bogdan-tirzioru/guitarAmp/README.md

# guitarAmp

STM32-based guitar effects and amplifier project. The first design focuses on a
working guitar audio path, headphone listening, a backing-track input, and USB
recording. Initial effects are overdrive and delay.

Status: hardware planning and CubeMX peripheral/pin allocation. Requirements below
describe the intended design, not completed or validated functionality.

## Power architecture and schematic status

The guitarAmp board is planned as a **self-powered** design using the external
±12 V supply shared with the reused LM1875 amplifier board. USB-C is for data and
VBUS detection; USB VBUS must not power the board.

The schematic still needs a complete power-entry and regulator design. The target
rails are ±12 V for the analog preamp, +3V3 for the STM32 and codec analog/I/O
domains, +1.8 V for the codec core, and +5 V for the Waveshare display module. The
generic display connector should carry the required +5 V module supply, +3V3 logic
rail, and ground; verify the exact Rev 4.0 module/adapter pinout and current draw
before freezing it. Regulator selection, current budgets, return paths, protection
and startup sequencing remain open.

The latest schematic review is tracked in
[`docs/schematic-todo.md`](docs/schematic-todo.md). Current blockers include the
codec DRVDD_1 supply, a floating common return for the eight control-filter
capacitors, three reversed polarized codec-input capacitors, input overload
protection/headroom, and the incomplete power tree. The control ADC paths, 1 MΩ
guitar input, display/UART connectors and SD-detect pull-up are reflected in the
current source. Native Altium ERC and hardware validation are still pending.

## Agreed requirements

| Area | Requirement |
| --- | --- |
| Guitar input | Mono instrument input with approximately 1 MΩ input impedance, protection, and suitable analog gain/headroom. |
| Backing-track input | Auxiliary line input. Accept stereo L/R at the connector and sum to mono before the codec using a proper summing circuit; never short source outputs together. |
| Conversion | One codec IC with two ADC channels and two DAC channels. Separate ADC/DAC ICs are outside the first-design scope. |
| Channel allocation | ADC left: guitar. ADC right: mono auxiliary. Keep sources separate until digital processing/mixing. |
| Bluetooth option | BM83SM1-00AB A2DP receiver; I²S into STM32, independent backing-track level, bypass guitar effects, included in the USB recording mix. |
| Effects | Process guitar through STM32 overdrive/delay; auxiliary audio bypasses guitar effects. |
| Mixing | Independent guitar and auxiliary levels, followed by output level control. Mix in STM32 so the backing track is included in USB recording. |
| Headphones | Headphone output is required, using the selected codec's integrated drivers. |
| Speaker output | Existing external LM1875 power-amplifier board, reused from the previous project and powered from the shared ±12 V supply. The guitarAmp interface, load, and measured output capability still need verification. |
| USB | High-speed USB planned. Audio recording of the digital mix is required; audio playback, HID, and mass-storage functions are planned, with implementation stages still to be defined. |
| Display/UI | Waveshare **3.5inch RPi LCD (A)**, 480×320 SPI TFT, is the selected development/reference display. Its Linux driver targets ILI9486 LCD and ADS7846-compatible resistive touch; verify the actual Rev 4.0 board before firmware bring-up. The guitarAmp PCB should expose a generic SPI TFT/touch interface rather than depend on the Raspberry Pi 40-pin connector. |
| Simplicity | Prioritize achievable analog hardware and bring-up over additional channels or maximum converter specifications. |
| Budget | Initial project target: approximately EUR 100; complete BOM cost has not been validated. |

Stereo auxiliary capture has been dropped for the first design. The stereo DAC
and headphone outputs remain available for stereo guitar effects or a mono mix
sent to both ears; stereo speaker amplification is not a fixed requirement.
Bluetooth backing-track reception is now an optional peripheral: BM83SM1-00AB,
with decoded digital audio mixed in STM32. The module may be fitted later.

## Selected codec: TI TLV320AIC3104

Selected orderable part: **TLV320AIC3104IRHBR**, as used by the ReSpeaker 2-Mics Pi
HAT V2.0 reference schematic.

Reasons for selection:

- Two ADCs and two DACs in one IC match the simplified audio architecture.
- Integrated headphone drivers and separate differential line outputs.
- Programmable input gain and output volume.
- I²C configuration and I²S-compatible audio connection to STM32 SAI.
- A concrete reference circuit is available in the ReSpeaker V2.0 design.

The device's multiple analog input pins feed only two ADC channels. They do not
provide additional simultaneous digital capture channels. The guitar still needs
an external high-impedance buffer/preamp; codec gain does not replace that stage.

Codec reference supplies are 3.3 V analog/I/O and 1.8 V digital core. Final
regulators, decoupling, power sequencing, input levels, and output coupling must be
checked against the datasheet before layout. Keep AGC disabled for the initial
guitar path to preserve playing dynamics.

## Audio routing

| Path | Routing |
| --- | --- |
| Guitar | Input jack → protection/high-impedance preamp → codec ADC left → STM32 effects |
| Auxiliary | Stereo input jack → L/R mono summing and level conditioning → codec ADC right → STM32 clean path |
| Mix | Processed guitar + clean auxiliary → digital output level → playback and USB recording |
| Headphones | STM32 mix → codec DACs/headphone drivers → coupling/protection → headphone jack |
| Speaker | STM32 mix → codec DACs/line outputs → analog interface → LM1875 → speaker |
| USB recording | STM32 digital mix → USB audio capture stream to host |

Separate dry guitar/auxiliary USB capture channels are an optional extension.
Do not mix auxiliary audio only after the DAC: that would omit it from the USB
recording path. For mono speaker playback, sum digitally or with a designed analog
stage; do not tie codec outputs together.

## MCU and digital hardware

The current [CubeMX project](firmwaredsp/firmwaredsp.ioc) targets
**STM32H5E5ZJT6, LQFP144**. Earlier STM32H7 options were explored; the checked-in
configuration is the current hardware-planning baseline.

| Function | Current allocation / intent |
| --- | --- |
| Codec audio | SAI1 block A master with clock; block B synchronous slave. Final TX/RX roles, framing, DMA, and clock values require configuration. |
| Codec control | I2C1, with a dedicated reset GPIO. |
| External RAM | OCTOSPI1 configured for HyperBus; HyperRAM is planned for audio buffers. Final memory part/capacity remains to be confirmed. |
| Removable storage | SDMMC1 configured for 4-bit SD; microSD planned. |
| Program storage | Use the STM32H5E5 internal Flash for firmware and DSP code. No external NOR is planned for the first design. |
| Bulk/user storage | Use microSD for backing tracks, recordings, impulse responses, user files, and firmware-update packages. eMMC has been dropped because it duplicates the microSD role while adding substantial cost and complexity. |
| USB | USB_OTG_HS configured as a device with internal PHY. |
| Bluetooth option | BM83 pins allocated on SAI2, USART3 and three GPIOs; SAI2 mode/rate and clock strategy still require resolution. |
| Display/touch | SPI2 plus GPIO chip selects/control and one EXTI input are allocated for the Waveshare 3.5inch RPi LCD (A) and its ADS7846-compatible touch interface. |
| Diagnostics | USART2 and SWD. |
| User interface | Touch display selected. Additional physical controls such as buttons, encoders/potentiometers and LEDs remain to be selected. |

The settled first-design memory architecture is STM32 internal Flash for code,
internal SRAM plus HyperRAM for working memory and audio buffers, and microSD for
large or frequently written files. External NOR and eMMC are outside the scope of
this STM32H5E5 guitarAmp revision; they may instead be evaluated for the separate
SBC project. The remaining memory and storage interfaces are allocated, not yet
proof of working hardware.

### Current codec-related pin allocation

| STM32 pin | CubeMX signal / intended purpose |
| --- | --- |
| PE2 | SAI1_MCLK_A → codec MCLK, if STM32 supplies the master clock |
| PE4 | SAI1_FS_A ↔ codec WCLK |
| PE5 | SAI1_SCK_A ↔ codec BCLK |
| PE6 | SAI1_SD_A; proposed transmit data to codec DIN |
| PE3 | SAI1_SD_B; proposed receive data from codec DOUT |
| PB6 | I2C1_SCL |
| PB7 | I2C1_SDA |
| PE0 | GPIO labelled SAI_reset; intended codec reset |

The latest `.ioc` selects 48 kHz / 24-bit audio and reports 47.999 kHz with
0.0% rounded error. PLL2P supplies approximately 49.152 MHz to SAI; PLL3Q remains
dedicated to the USB PHY at 16 MHz. Preserve this allocation when adding Bluetooth.
These settings establish the hardware-planning baseline, not hardware validation.

## Selected display: Waveshare 3.5inch RPi LCD (A)

The selected development/reference display is the **Waveshare 3.5inch RPi LCD (A)**,
480×320, using an SPI TFT interface and resistive touch. Waveshare's `LCD35-show`
script installs the `waveshare35a` overlay. Its Linux device-tree source selects
`ilitek,ili9486` for the LCD and `ti,ads7846` for touch, with separate SPI chip
selects and an LCD SPI limit of 16 MHz in that overlay. Thus **ILI9486** is our
LCD driver target and **ADS7846-compatible** is our touch driver target, not
ILI9341. The overlay identifies the Linux driver compatibility; it does not
independently prove the IC markings on our particular Rev 4.0 board. Check the
board markings or test the display before treating that hardware identification
as confirmed. Use the overlay's panel initialization sequence as a reference
when porting the LCD driver to STM32.
The parallel 3.2-inch Arduino Mega display was rejected for this revision because
its wide parallel interface consumes too many MCU pins and the available module has
no touch capability. The Nokia displays remain experiments, not the baseline UI.

The main PCB should not copy the Raspberry Pi 40-pin header. Instead, expose the
required SPI and control signals on a generic display connector so the current
Waveshare module can be used through an adapter and a future SPI TFT can be
substituted without redesigning the complete guitarAmp board.

### Current CubeMX display/touch allocation

| STM32 pin | CubeMX function / label | Display connection |
| --- | --- | --- |
| PB13 | SPI2_SCK | Shared LCD / touch SPI clock |
| PB15 | SPI2_MOSI | Shared LCD / touch data from MCU |
| PB14 | SPI2_MISO | Touch data to MCU |
| PB12 | GPIO output `LCD_CS` | LCD chip select |
| PB10 | GPIO output `TOUCH_CS` | Touch chip select |
| PE14 | GPIO output `LCD_RS` | LCD register-select / data-command |
| PE15 | GPIO output `LCD_RESET` | LCD reset |
| PE13 | EXTI13 input `EXTI13_TOUCH_IRQ` | Touch interrupt |

SPI2 remains a full-duplex master because the LCD is mainly write-only while the
touch controller must return coordinate data on MISO. LCD and touch use separate
software-controlled chip selects and share SCK/MOSI/MISO. FMC is not used for the
display.

The checked-in `.ioc` currently reports a high SPI2 baud-rate setting; final SPI
prescalers, ILI9486 limits, touch-controller timing and signal integrity must be
validated before schematic freeze/firmware bring-up. DMA is desirable for large TFT
updates so display traffic does not unnecessarily consume CPU time needed by the
audio path, but DMA configuration is not yet documented as complete.

## Optional Bluetooth peripheral and CubeMX pin plan

Selected candidate: **Microchip BM83SM1-00AB**, Mouser **579-BM83SM1-00AB**.
Fit the module directly on the PCB, with the option to leave it unpopulated.
Use A2DP reception and digital I²S output; retain TLV320AIC3104 as the analog codec.

Routing: phone → BM83 → SAI2 receive → sample-rate alignment → independent
backing-track gain → STM32 mixer after guitar effects → codec and USB recording.
The wired auxiliary path remains available. Stereo Bluetooth does not require
extra ADC channels; define stereo/headphone and mono-speaker mixing in the DSP.

### Current pin allocation and remaining configuration

The user has applied the following pins in the checked-in `.ioc`. They do not
conflict with the existing codec, storage, USB or display pin allocations. Alternate
functions were checked against STM32H5Exxx DS14971, tables 14 and 15.

| STM32 pin | CubeMX function / label | BM83 connection |
| --- | --- | --- |
| PD11 | SAI2_SD_A, AF10 | DT1, pin 4 → MCU |
| PD12 | SAI2_FS_A, AF10 | RFS1, pin 2 |
| PD13 | SAI2_SCK_A, AF10 | SCLK1, pin 3 |
| PD8 | USART3_TX, AF7 | MCU → UART_RXD, pin 29 |
| PD9 | USART3_RX, AF7 | UART_TXD, pin 30 → MCU |
| PD10 | GPIO output, BM83_reset | BC847 open-collector stage to RST_N, pin 43: PD10 through 4.7 kΩ to base; 100 kΩ base-emitter pull-down; emitter to GND; collector to RST_N. PD10 high asserts reset. |
| PD14 | GPIO output, BM83_WAKE1 | MFB, pin 26 through 1 kΩ series resistor; 100 kΩ pull-down to GND at module side. High wakes/keeps BM83 active; low requests power-save. |
| PD15 | GPIO input, BM83_IND | P0_0 / UART_TX_IND, pin 49 |

Current CubeMX review:
- SAI2 block A is currently selected as master without MCLK and the checked-in
  configuration reports approximately 47.999 kHz. This still is not the proposed
  independent-clock receive configuration. If BM83 supplies BCLK/FS, select
  asynchronous slave receive on block A. If STM32 supplies them instead, resolve
  BM83 client-mode behavior and select the intended receive direction explicitly.
- USART3 TX/RX is allocated on PD8/PD9. USART2 diagnostics uses PA2 TX and PA3 RX.
- PD15 is an ordinary GPIO input, not EXTI. Polling is possible; select EXTI only
  if interrupt-based host wake is required.
- SAI1 codec pins, 48 kHz/24-bit settings, PLL2 audio and PLL3 USB are preserved.
  HyperRAM and the SDMMC1 microSD interface retain their signal pin assignments;
  SDMMC2/eMMC remains disabled.
  PD1 remains an output but its former SD_RESET label has been removed.

Final I²S framing/data width and slot length must match the BM83 configuration.
Control GPIO drive type, pulls and reset states depend on the schematic interface.
These findings are documented here; this documentation branch does not alter the
user's CubeMX file or generate firmware.

### Clock decision before schematic freeze

The conservative option is BM83 as I²S clock master and SAI2 as slave receiver,
with asynchronous sample-rate conversion into the local 48 kHz audio domain.
This keeps codec SAI1/PLL2 and USB PLL3 independent. Reserve processing budget;
FIFO buffering alone cannot handle continuous clock drift or 44.1-to-48 kHz conversion.

BM83 also supports I²S client mode. A shared-clock alternative may avoid an MCU
ASRC, but requires confirmation that the selected module firmware handles source
rate conversion and radio clock drift at a fixed external 48 kHz rate. Do not
assume client-mode support alone proves this. The same BCLK/FS pins allow revisiting
clock direction without reallocating the existing codec pins.

BM83 MCLK1 is an **output**, not an MCU clock input to the module. Do not connect
it to codec MCLK/PE2. No MCU MCLK pin is reserved for this receive-only option.
Leave DR1 unused unless transmit functionality is added.

### Schematic provisions still required

- Implement reset with a BC847 open-collector stage: PD10 through 4.7 kΩ to
  base, 100 kΩ base-emitter pull-down, emitter to GND, collector to RST_N pin 43.
  The BM83 has an internal RST_N pull-up; PD10 high asserts reset. Drive MFB pin 26
  directly from PD14 through 1 kΩ, with a 100 kΩ pull-down at the module side;
  high wakes/keeps BM83 active and low requests power-save. Verify module supply
  and behavior if BAT_IN is removed while the MCU remains powered.
- Keep the specified antenna clearance and place the antenna at the PCB edge.
- Expose UART and the module application/test strap for configuration access.
- Resolve UART hardware-flow-control needs before layout. PD11/PD12 are used
  for audio, so they cannot also serve USART3 CTS/RTS; use alternative AF pins
  if the selected configuration requires them.
- Configure the module for MCU control and the selected digital-audio mode;
  factory configuration is not proof of the intended interface behavior.

Scope: peripheral and schematic planning only. No Bluetooth firmware, generated
code, or CubeMX configuration changes are included in this plan.

References:
- [BM83 datasheet, sections 2.2, 6.5 and 6.6](https://ww1.microchip.com/downloads/aemDocuments/documents/WSG/ProductDocuments/DataSheets/BM83-Bluetooth-Stereo-Audio-Module-Data-Sheet-DS70005402.pdf)
- [STM32H5Exxx datasheet](https://www.st.com/resource/en/datasheet/stm32h5e5zj.pdf)

## ReSpeaker V2.0 reference

Reference document: `202004059_ReSpeaker-2-Mics-Pi-HAT-V2.0_SCH_PDF_241121(1).pdf`,
revision V2.0 dated 2024-11-15, supplied during design review. The PDF is not
currently included in this repository.

Page 4 provides the audio circuit; page 2 confirms the change from WM8960 to
TLV320AIC3104. Useful reference elements include:

- 3.3 V rails and a separate 1.8 V core regulator.
- A 24.576 MHz active oscillator, with alternative clock-source resistor options.
- I²C, I²S, and reset connections.
- Headphone outputs using 47 µF coupling capacitors and filtering/protection.
- A separate TPA2005D1 speaker amplifier fed from codec line outputs.

Adapt the microphone circuits to our guitar and auxiliary inputs, and replace the
reference speaker amplifier with the planned LM1875 stage. Verify headphone
left/right mapping: the reference HPLOUT/HPROUT net labels appear swapped after
the coupling capacitors. Size coupling capacitors for the selected headphone load
and bass response rather than copying 47 µF without checking.

## Open decisions and bring-up plan

1. Finish guitar preamp and auxiliary summing/attenuation circuits, including
   clipping headroom, input protection, and AC coupling.
2. Retain the current STM32/PLL2 codec-clock baseline. Resolve the optional
   BM83 clock-domain strategy before freezing its schematic; PLL3 remains for USB.
3. Use 48 kHz with 24-bit samples in 32-bit slots as the proposed initial firmware
   target; verify codec registers and SAI timing together.
4. Finalize headphone impedance/output level, jack wiring, volume ramp/mute, and
   speaker muting when headphones are inserted.
5. Verify the reused LM1875 board's supply connection, speaker load,
   gain/headroom, cooling, and output level in the complete assembly.
6. Bring up rails/reset/I²C first, then DAC test tone, ADC capture, clean
   pass-through, effects/mixing, and USB recording of both sources.
7. Measure round-trip latency, clipping/noise, and sustained DMA/USB operation.
   No numeric end-to-end latency target has yet been agreed.
8. Finalize the generic display connector and physical user controls around the
   selected Waveshare 3.5inch SPI/touch baseline; add storage/UI firmware after
   the audio path works.

## Repository contents and references

- [`firmwaredsp/firmwaredsp.ioc`](firmwaredsp/firmwaredsp.ioc): CubeMX configuration.
- [`AN/`](AN/): MCU reference documents.
- [TI TLV320AIC3104 datasheet](https://www.ti.com/lit/ds/symlink/tlv320aic3104.pdf).
- [Waveshare 3.5inch RPi LCD (A) wiki](https://www.waveshare.com/wiki/3.5inch_RPi_LCD_%28A%29).
- [Waveshare LCD35-show installation script](https://github.com/waveshareteam/LCD-show/blob/master/LCD35-show).
- [waveshare35a Linux overlay source](https://github.com/swkim01/waveshare-dtoverlays/blob/master/waveshare35a.dts) (ILI9486, ADS7846-compatible touch and panel initialization).

Requirements recorded from design discussions through 2026-09-24. Component
selection and peripheral allocation do not imply that hardware or firmware has
been validated.

## Initial LED application

LED0 (PC13) is driven high at the end of GPIO initialization, before the
remaining peripheral initializers run. LED1 (PC14) starts low and toggles every
500 ms once the main loop is reached: 500 ms on, 500 ms off (1 Hz). The LEDs
are assumed active-high. The heartbeat uses `HAL_GetTick()` without blocking the
main loop and handles the millisecond tick counter wrapping.

The application additions are in CubeMX `USER CODE` sections and are preserved
when regenerating with the current IOC (`ProjectManager.KeepUserCode=true`).
Existing clock and peripheral initialization remains enabled; if an initializer
enters `Error_Handler()`, LED1 will not blink. LED0 indicates GPIO initialization
was reached, not that all peripherals initialized successfully.

## Codec firmware module

The TLV320AIC3104 control driver and STM32 HAL adapter are included in the firmware
project. See [module API, profile and startup](docs/tlv320aic3104.md).
`main()` uses one build-time strap in `firmwaredsp/Core/Inc/app_config.h`:

- `GUITARAMP_CODEC_ENABLE=0`: skip codec execution (default while no board is available).
- `GUITARAMP_CODEC_ENABLE=1`: start silent SAI clocks and initialize the real codec,
  keeping its DAC muted.

The LED application continues in either mode. Real audio capture/DSP and physical
validation remain pending.

## Serial logging

BA2's queued DMA console is ported to USART2 on PA2/PA3 at **115200 8N1**, using
GPDMA1 channel 0. Use `Console_Write` and `Console_Printf` for non-blocking serial
logging. Startup reports CPU clock and codec status. See
[console API and DMA ownership](docs/serial-console.md). Hardware validation is
pending; USART3 remains allocated to BM83.
