bogdan-tirzioru/guitarAmp/(list of files, drawings)

Other design files:
layout/guitarDSP/audio.SchDoc
layout/guitarDSP/bluetooth.SchDoc
layout/guitarDSP/dsp.PcbDoc
layout/guitarDSP/guitarDSP.PrjPcb
layout/guitarDSP/memory.SchDoc
layout/guitarDSP/microcontroller.SchDoc
layout/guitarDSP/powersupply.SchDoc
