bogdan-tirzioru/guitarAmp/firmwaredsp/Core/Src/main.c

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
/* Includes ------------------------------------------------------------------*/
#include "main.h"

/* USER CODE BEGIN Includes */
#include "console.h"
#include "console_board.h"
#include "app_config.h"
#include "codec_app.h"

/* USER CODE END Includes */

ADC_HandleTypeDef hadc1;

I2C_HandleTypeDef hi2c1;

XSPI_HandleTypeDef hxspi1;

SAI_HandleTypeDef hsai_BlockA1;
SAI_HandleTypeDef hsai_BlockB1;
SAI_HandleTypeDef hsai_BlockA2;

SD_HandleTypeDef hsd1;

SPI_HandleTypeDef hspi2;

TIM_HandleTypeDef htim2;

UART_HandleTypeDef huart2;
UART_HandleTypeDef huart3;
DMA_HandleTypeDef handle_GPDMA1_Channel0;

PCD_HandleTypeDef hpcd_USB_OTG_HS;

/* USER CODE BEGIN PV */
volatile HAL_StatusTypeDef console_startup_status = HAL_ERROR;
#if GUITARAMP_CODEC_ENABLE
static codec_app_state_t last_codec_state;
#endif

/* USER CODE END PV */

void SystemClock_Config(void);
void PeriphCommonClock_Config(void);
static void MPU_Config(void);
static void MX_GPIO_Init(void);
static void MX_GPDMA1_Init(void);
static void MX_ICACHE_Init(void);
static void MX_OCTOSPI1_Init(void);
static void MX_SDMMC1_SD_Init(void);
static void MX_USB_OTG_HS_PCD_Init(void);
static void MX_I2C1_Init(void);
static void MX_SAI1_Init(void);
static void MX_USART2_UART_Init(void);
static void MX_SAI2_Init(void);
static void MX_USART3_UART_Init(void);
static void MX_SPI2_Init(void);
static void MX_ADC1_Init(void);
static void MX_TIM2_Init(void);
/**
  * @brief  The application entry point.
  * @retval int
  */
int main(void)
{

  /* USER CODE BEGIN 1 */
  uint32_t led1_last_toggle;

  /* USER CODE END 1 */

  /* MCU Configuration--------------------------------------------------------*/

  /* MPU Configuration--------------------------------------------------------*/
  MPU_Config();

  /* Reset of all peripherals, Initializes the Flash interface and the Systick. */
  HAL_Init();

  /* Configure the system clock */
  SystemClock_Config();

  /* Configure the peripherals common clocks */
  PeriphCommonClock_Config();

  /* Initialize all configured peripherals */
  MX_GPIO_Init();
  MX_GPDMA1_Init();
  MX_ICACHE_Init();
  MX_OCTOSPI1_Init();
  MX_SDMMC1_SD_Init();
  MX_USB_OTG_HS_PCD_Init();
  MX_I2C1_Init();
  MX_SAI1_Init();
  MX_USART2_UART_Init();
  MX_SAI2_Init();
  MX_USART3_UART_Init();
  MX_SPI2_Init();
  MX_ADC1_Init();
  MX_TIM2_Init();
  /* USER CODE BEGIN 2 */
  console_startup_status = Console_Board_Init(&huart2);
  Console_Write("\r\nguitarAmp console ready\r\n");
  Console_Printf("CPU clock: %lu Hz\r\n", (unsigned long)HAL_RCC_GetSysClockFreq());
#if GUITARAMP_CODEC_ENABLE
  Console_Write("codec: starting\r\n");
  codec_app_start(&hi2c1, &hsai_BlockA1);
  last_codec_state = codec_app_state;
  Console_Printf("codec: state=%u result=%u\r\n",
                 (unsigned)codec_app_state, (unsigned)codec_app_result);
#else
  Console_Write("codec: disabled\r\n");
#endif
  led1_last_toggle = HAL_GetTick();

  /* USER CODE END 2 */

  /* Infinite loop */
  /* USER CODE BEGIN WHILE */
  while (1)
  {
    /* USER CODE END WHILE */

    /* USER CODE BEGIN 3 */
    Console_Process();
#if GUITARAMP_CODEC_ENABLE
    codec_app_process();
    if (last_codec_state != codec_app_state)
    {
      last_codec_state = codec_app_state;
      Console_Printf("codec: state=%u result=%u\r\n",
                     (unsigned)codec_app_state, (unsigned)codec_app_result);
    }
#endif
    uint32_t now = HAL_GetTick();

    if ((uint32_t)(now - led1_last_toggle) >= 500U)
    {
      led1_last_toggle = now;
      HAL_GPIO_TogglePin(LED1_GPIO_Port, LED1_Pin);
    }
  }
  /* USER CODE END 3 */
}

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
 /* MPU Configuration */

static void MPU_Config(void)
{
  MPU_Region_InitTypeDef MPU_InitStruct = {0};
  MPU_Attributes_InitTypeDef MPU_AttributesInit = {0};

  /* Disables the MPU */
  HAL_MPU_Disable();

  /** Initializes and configures the Region 0 and the memory to be protected
  */
  MPU_InitStruct.Enable = MPU_REGION_ENABLE;
  MPU_InitStruct.Number = MPU_REGION_NUMBER0;
  MPU_InitStruct.BaseAddress = 0x08FFF000;
  MPU_InitStruct.LimitAddress = 0x08FFFFFF;
  MPU_InitStruct.AttributesIndex = MPU_ATTRIBUTES_NUMBER0;
  MPU_InitStruct.AccessPermission = MPU_REGION_ALL_RO;
  MPU_InitStruct.DisableExec = MPU_INSTRUCTION_ACCESS_DISABLE;
  MPU_InitStruct.IsShareable = MPU_ACCESS_NOT_SHAREABLE;

  HAL_MPU_ConfigRegion(&MPU_InitStruct);

  /** Initializes and configures the Attribute 0 and the memory to be protected
  */
  MPU_AttributesInit.Number = MPU_ATTRIBUTES_NUMBER0;
  MPU_AttributesInit.Attributes = INNER_OUTER(MPU_NOT_CACHEABLE);

  HAL_MPU_ConfigMemoryAttributes(&MPU_AttributesInit);
  /* Enables the MPU */
  HAL_MPU_Enable(MPU_PRIVILEGED_DEFAULT);

}

/**
  * @brief  This function is executed in case of error occurrence.
  * @param None
  * @retval None
  */
void Error_Handler(void)
{
  /* USER CODE BEGIN Error_Handler_Debug */
  /* User can add his own implementation to report the HAL error return state */
  __disable_irq();
  while (1)
  {
  }
  /* USER CODE END Error_Handler_Debug */
}
#ifdef USE_FULL_ASSERT
/**
  * @brief  Reports the name of the source file and the source line number
  *         where the assert_param error has occurred.
  * @param  file: pointer to the source file name
  * @param  line: assert_param error line source number
  * @retval None
  */
void assert_failed(uint8_t *file, uint32_t line)
{
  /* USER CODE BEGIN 6 */
  /* User can add his own implementation to report the file name and line number,
     ex: printf("Wrong parameters value: file %s on line %d\r\n", file, line) */
  /* USER CODE END 6 */
}
#endif /* USE_FULL_ASSERT */
