bogdan-tirzioru/guitarAmp/firmwaredsp/firmwaredsp.ioc

Mcu.UserName=STM32H5E5ZJTx
PA0.Signal=ADCx_INP0
PA1.Signal=ADCx_INP1
PA10.Signal=SDMMC1_D0
PA2.Signal=USART2_TX
PA3.Signal=USART2_RX
PA6.Signal=OCTOSPIM_P1_IO3
PA7.Signal=OCTOSPIM_P1_IO2
PA9.GPIO_Label=USB_DETECT
PA9.Signal=GPIO_Input
PB0.Signal=OCTOSPIM_P1_IO1
PB1.Signal=OCTOSPIM_P1_IO0
PB10.GPIO_Label=TOUCH_CS
PB10.Signal=GPIO_Output
PB12.GPIO_Label=LCD_CS
PB12.Signal=GPIO_Output
PB13.Signal=SPI2_SCK
PB14.Signal=SPI2_MISO
PB15.Signal=SPI2_MOSI
PB2.Signal=OCTOSPIM_P1_CLK
PB6.Signal=I2C1_SCL
PB7.Signal=I2C1_SDA
PC0.Signal=ADCx_INP10
PC1.Signal=ADCx_INP11
PC10.Signal=SDMMC1_D2
PC11.Signal=SDMMC1_D3
PC12.Signal=SDMMC1_CK
PC13.GPIO_Label=LED0
PC13.Signal=GPIO_Output
PC14-OSC32_IN(OSC32_IN).GPIO_Label=LED1
PC14-OSC32_IN(OSC32_IN).Signal=GPIO_Output
PC15-OSC32_OUT(OSC32_OUT).GPIO_Label=LED2
PC15-OSC32_OUT(OSC32_OUT).Signal=GPIO_Output
PC2.Signal=ADCx_INP12
PC4.Signal=ADCx_INP4
PC5.Signal=OCTOSPIM_P1_DQS
PC9.Signal=SDMMC1_D1
PD0.GPIO_Label=SD_CARDDET
PD0.Signal=GPIO_Input
PD1.GPIO_Label=SDMMC1_RESET
PD1.Signal=GPIO_Output
PD10.GPIO_Label=BM83_reset
PD10.Signal=GPIO_Output
PD11.Signal=SAI2_SD_A
PD12.Signal=SAI2_FS_A
PD13.Signal=SAI2_SCK_A
PD14.GPIO_Label=BM83_WAKE1
PD14.Signal=GPIO_Output
PD15.GPIO_Label=BM83_IND
PD15.Signal=GPIO_Input
PD2.Signal=SDMMC1_CMD
PD8.Signal=USART3_TX
PD9.Signal=USART3_RX
PE0.GPIO_Label=SAI_reset
PE0.Signal=GPIO_Output
PE10.Signal=OCTOSPIM_P1_IO7
PE11.Signal=OCTOSPIM_P1_NCS1
PE12.GPIO_Label=octo_reset
PE12.Signal=GPIO_Output
PE13.GPIO_Label=EXTI13_TOUCH_IRQ
PE13.Signal=GPXTI13
PE14.GPIO_Label=LCD_RS
PE14.Signal=GPIO_Output
PE15.GPIO_Label=LCD_RESET
PE15.Signal=GPIO_Output
PE2.Signal=SAI1_MCLK_A
PE3.Signal=SAI1_SD_B
PE4.Signal=SAI1_FS_A
PE5.Signal=SAI1_SCK_A
PE6.Signal=SAI1_SD_A
PE7.Signal=OCTOSPIM_P1_IO4
PE8.Signal=OCTOSPIM_P1_IO5
PE9.Signal=OCTOSPIM_P1_IO6
PF0.Signal=S_TIM2_CH1
PF1.Signal=S_TIM2_CH2
PF11.Signal=ADC1_INP2
PF12.Signal=ADC1_INP6
PF2.GPIO_Label=ENC_EXTI2
PF2.Signal=GPXTI2
PH0-OSC_IN(PH0).Signal=RCC_OSC_IN
PH1-OSC_OUT(PH1).Signal=RCC_OSC_OUT
