bogdan-tirzioru/guitarAmp/(commit log)

2026-09-19 docs: add optional BM83 and proposed CubeMX pin allocation
2026-09-19 add spi display interface
2026-09-19 create project in altium
    [guitarDSP.PrjPcb, microcontroller.SchDoc]
2026-09-20 add schematic to project
    [guitarDSP.PrjPcb, memory.SchDoc, microcontroller.SchDoc]
2026-09-20 further remarks implemented
    [memory.SchDoc]
2026-09-20 feather refinements on schematic
    [dsp.PcbDoc, guitarDSP.PrjPcb, memory.SchDoc, microcontroller.SchDoc]
2026-09-24 set display waveshare 3.5inch RPi LCD (A)
    [dsp.PcbDoc, guitarDSP.PrjPcb, memory.SchDoc, microcontroller.SchDoc]
2026-09-24 fix the encaoder and analog inputs
    [firmwaredsp.ioc]
2026-09-25 Document Waveshare 3.5-inch LCD driver targets
2026-09-27 more power connections on mcu
    [memory.SchDoc, microcontroller.SchDoc]
2026-09-29 set connector for usb
    [microcontroller.SchDoc]
2026-10-01 Add startup LED and nonblocking 500 ms heartbeat
2026-10-01 Document initial LED application
2026-10-01 Add portable TLV320AIC3104 control driver and STM32 HAL adapter
2026-10-01 Integrate codec startup and self-test into firmware behind build-time straps
2026-10-01 Remove simulated codec tests and keep only codec enable strap
2026-10-01 Port BA2 queued DMA serial console to guitarAmp USART2
2026-10-01 Move USART2 console DMA and IRQ ownership to CubeMX
2026-10-02 initial setup of analog input
    [memory.SchDoc]
2026-10-02 fix power 1.8V source
    [memory.SchDoc]
2026-10-04 audio schematic
    [audio.SchDoc, bluetooth.SchDoc, guitarDSP.PrjPcb, memory.SchDoc, microcontroller.SchDoc]
2026-10-04 setup pots for ANs
    [microcontroller.SchDoc]
2026-10-05 docs: add prioritized Altium schematic review checklist
2026-10-05 connect the analog lines
    [audio.SchDoc, microcontroller.SchDoc]
2026-10-06 docs: re-evaluate schematic fixes and update remaining findings
2026-10-06 docs: clarify reuse of existing external LM1875 amplifier board
2026-10-06 docs: verify reused LM1875 input coupling and document codec connection
2026-10-09 implement more rview remarks
    [audio.SchDoc, microcontroller.SchDoc]
2026-10-10 fix the sd detect pull up
    [audio.SchDoc, memory.SchDoc, microcontroller.SchDoc]
2026-10-10 add lcd interface and serial log
    [microcontroller.SchDoc]
2026-10-10 set usb shield
    [microcontroller.SchDoc]
2026-10-10 docs: update guitarAmp power and schematic status
2026-10-10 docs: refresh schematic review checklist
2026-10-10 docs: wrap power architecture details
2026-10-10 docs: correct schematic review work order
2026-10-11 setup BT schematic- minimal
2026-10-11 Review updated BM83 schematic findings
2026-10-11 Polish Bluetooth schematic review references
2026-10-11 Correct stale schematic summary statuses
2026-10-11 Update control review from latest schematic view
2026-10-11 Record 220 nF guitar input capacitor in review summary
2026-10-11 Update audio capacitor review for non-polar SMD replacements
2026-10-11 Re-review complete schematic checklist at latest Altium baseline
2026-10-11 Refresh MCU interface status table from latest schematic
2026-10-11 fix the power for BT
2026-10-11 insert the power delivery stage
2026-10-11 adnotation of schematic
2026-10-11 Review power stage and refresh all schematic findings at a92aa22
